nswardana11/agility-tester/assets/img/PCB-ControlBox.png

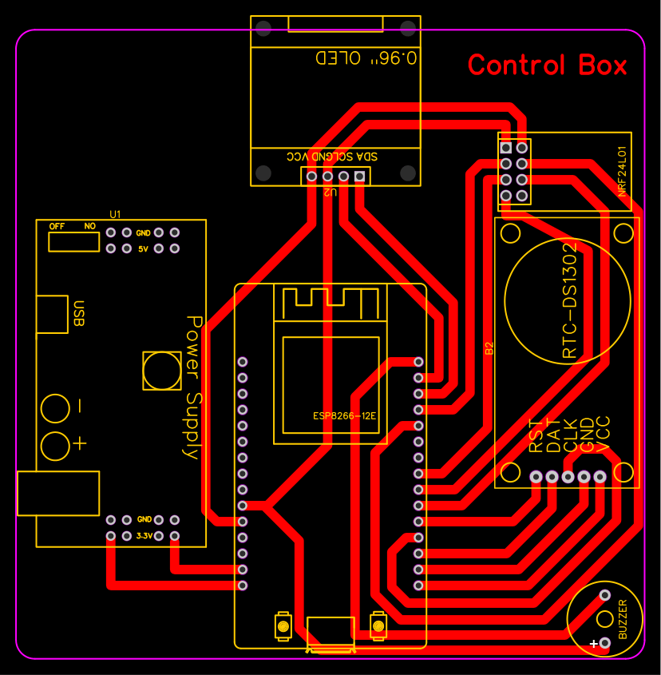
assets/img/PCB-ControlBox.png
