nswardana11/agility-tester/assets/img/PCB-Node.png

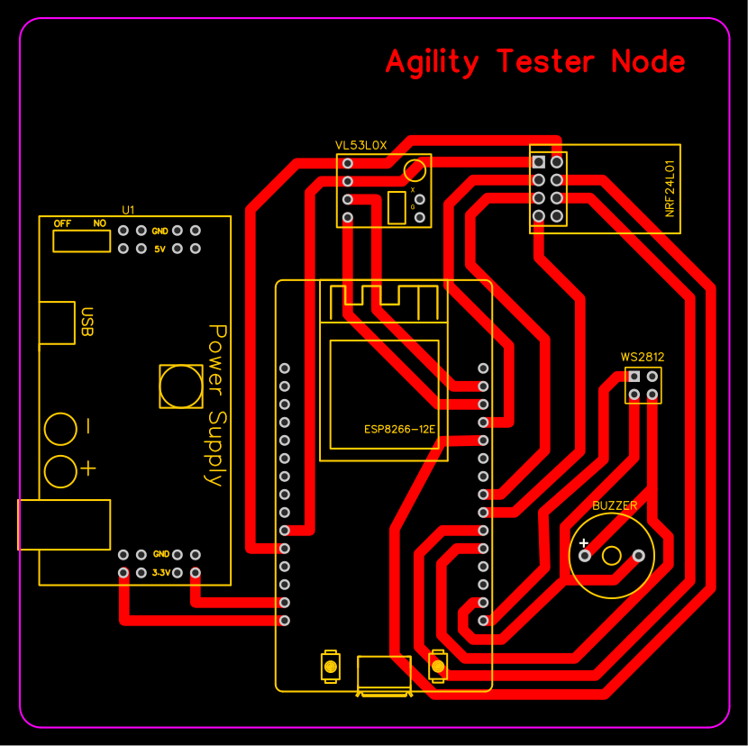
assets/img/PCB-Node.png
